j1mb0/ECE411/MotionControlledLampBOM.pdf

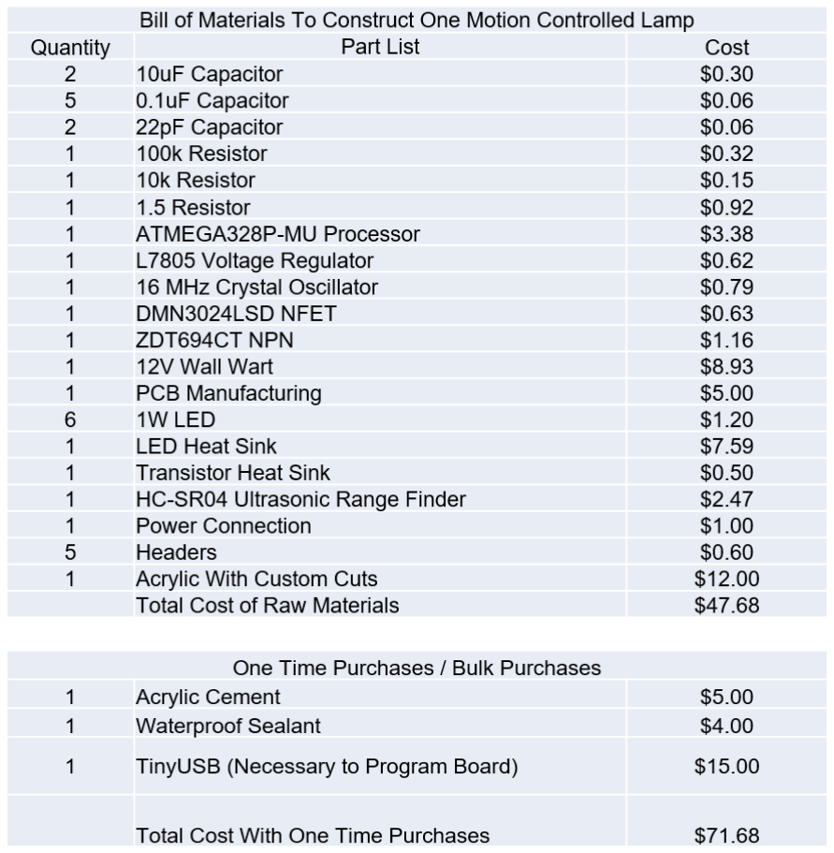
[picture p5: page 1]
