j1mb0/ECE411/T03_Eagle_Files/T03_MotionControledLampLedDriver.brd

## EAGLE design T03_Eagle_Files/T03_MotionControledLampLedDriver.brd (2015-11-16)

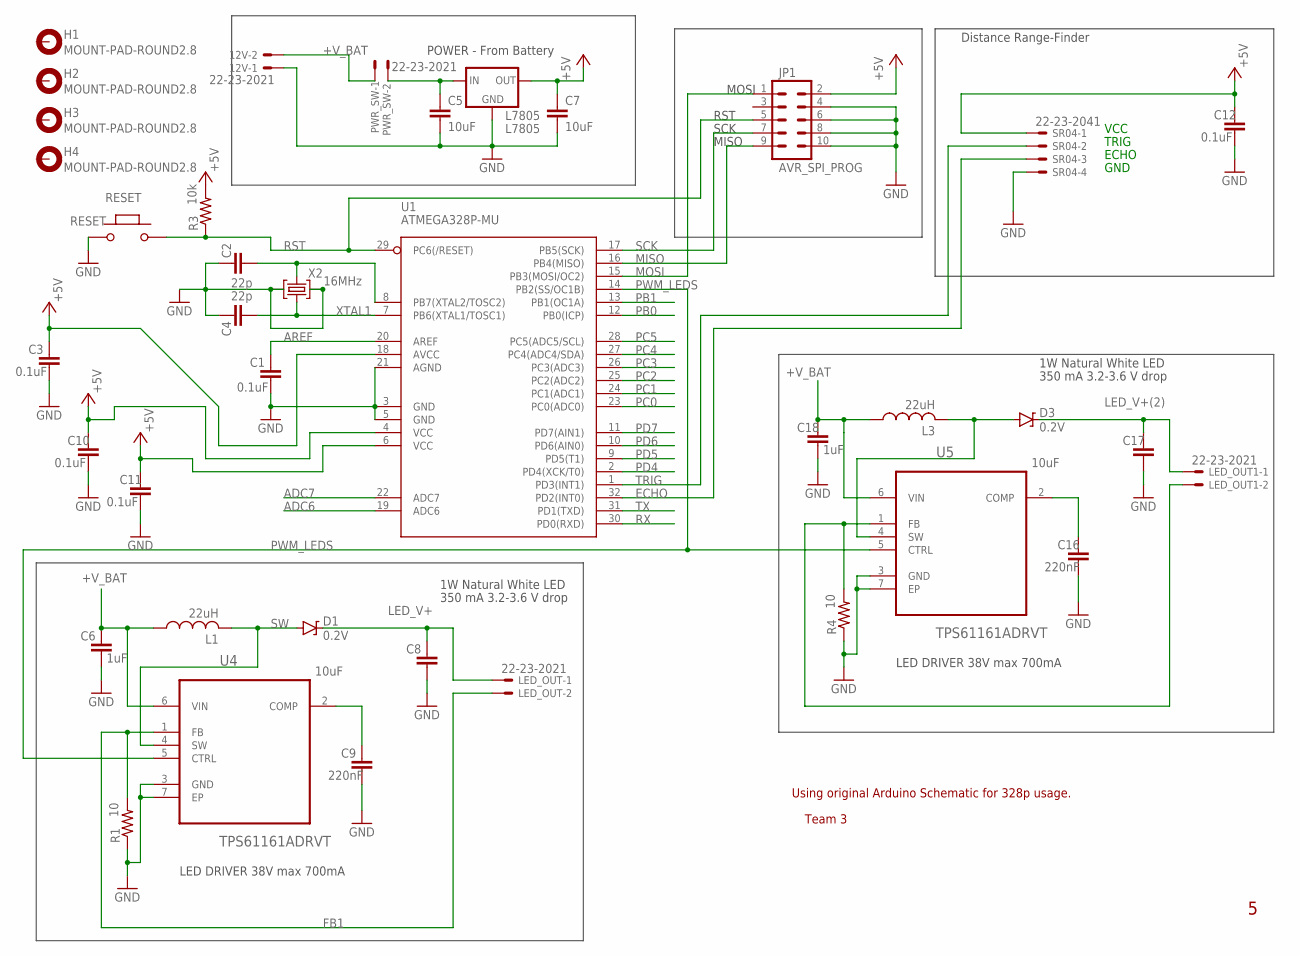
[picture p6: schematic T03_MotionControledLampLedDriver.sch]

Parts:
12V: 22-23-2021
C1, C3, C10, C11, C12: 0.1uF; C0603-ROUND
C2, C4: 22p; C0603-ROUND
C5, C7: 10uF; C1206
C6, C18: 1uF; C0603-ROUND
C8, C17: 10uF; C0603-ROUND
C9, C16: 220nF; C0603-ROUND
D1, D3: 0.2V; SOD-323
H1, H2, H3, H4: MOUNT-PAD-ROUND2.8; 2,8-PAD
JP1: AVR_SPI_PROG; 2X5-SHROUDED_LOCK
L1, L3: 22uH; L4532P
L7805: L7805; 78XXL
LED_OUT, LED_OUT1: 22-23-2021
PWR_SW: 22-23-2021
R1, R4: 10; M1206
R3: 10k; M1206
RESET: RESET; SMD_157SW
SR04: 22-23-2041
U1: ATMEGA328P-MU; TQFP32-08
U4, U5: TPS61161ADRVT; SON65P200X200X80-7N
X2: 16MHz; CRYSTAL-3.2-2.5

Connections:
+5V: C3.2, C7.1, C10.2, C11.2, C12.2, JP1.2, L7805.OUT, R3.2, SR04.1, U1.4 (VCC), U1.6 (VCC), U1.18 (AVCC)
+V_BAT: 12V.2, C6.2, C18.2, L1.1, L3.1, PWR_SW.1, U4.6 (VIN), U5.6 (VIN)
ADC6: U1.19 (ADC6)
ADC7: U1.22 (ADC7)
AREF: C1.2, U1.20 (AREF)
COMP: C9.2, U4.2 (COMP)
COMP1: C16.2, U5.2 (COMP)
ECHO: SR04.3, U1.32 (PD2(INT0))
FB1: LED_OUT.2, R1.2, U4.1 (FB)
FB2: LED_OUT1.2, R4.2, U5.1 (FB)
GND: 12V.1, C1.1, C2.2, C3.1, C4.2, C5.2, C6.1, C7.2, C8.1, C9.1, C10.1, C11.1, C12.1, C16.1, C17.1, C18.1, JP1.4, JP1.6, JP1.8, JP1.10, L7805.GND, R1.1, R4.1, RESET.1, SR04.4, U1.3 (GND), U1.5 (GND), U1.21 (AGND), U4.3 (GND), U4.7 (EP), U5.3 (GND), U5.7 (EP), X2.2 (GND), X2.4 (GND)
LED_V+: C8.2, D1.C, LED_OUT.1
LED_V+(2): C17.2, D3.C, LED_OUT1.1
MISO: JP1.9, U1.16 (PB4(MISO))
MOSI: JP1.1, U1.15 (PB3(MOSI/OC2))
unnamed: C5.1, L7805.IN, PWR_SW.2
PB0: U1.12 (PB0(ICP))
PB1: U1.13 (PB1(OC1A))
PC0: U1.23 (PC0(ADC0))
PC1: U1.24 (PC1(ADC1))
PC2: U1.25 (PC2(ADC2))
PC3: U1.26 (PC3(ADC3))
PC4: U1.27 (PC4(ADC4/SDA))
PC5: U1.28 (PC5(ADC5/SCL))
PD4: U1.2 (PD4(XCK/T0))
PD5: U1.9 (PD5(T1))
PD6: U1.10 (PD6(AIN0))
PD7: U1.11 (PD7(AIN1))
PWM_LEDS: U1.14 (PB2(SS/OC1B)), U4.5 (CTRL), U5.5 (CTRL)
RST: JP1.5, R3.1, RESET.2, U1.29 (PC6(/RESET))
RX: U1.30 (PD0(RXD))
SCK: JP1.7, U1.17 (PB5(SCK))
SW: D1.A, L1.2, U4.4 (SW)
SW1: D3.A, L3.2, U5.4 (SW)
TRIG: SR04.2, U1.1 (PD3(INT1))
TX: U1.31 (PD1(TXD))
XTAL1: C4.1, U1.7 (PB6(XTAL1/TOSC1)), X2.1 (C1)
XTAL2: C2.1, U1.8 (PB7(XTAL2/TOSC2)), X2.3 (C2)

Notes on the sheet:
POWER - From Battery
Distance Range-Finder
RST
MISO
SCK
MOSI
LED DRIVER 38V max 700mA
1W Natural White LED
350 mA 3.2-3.6 V drop
Using original Arduino Schematic for 328p usage.
Team 3
VCC
TRIG
ECHO
GND

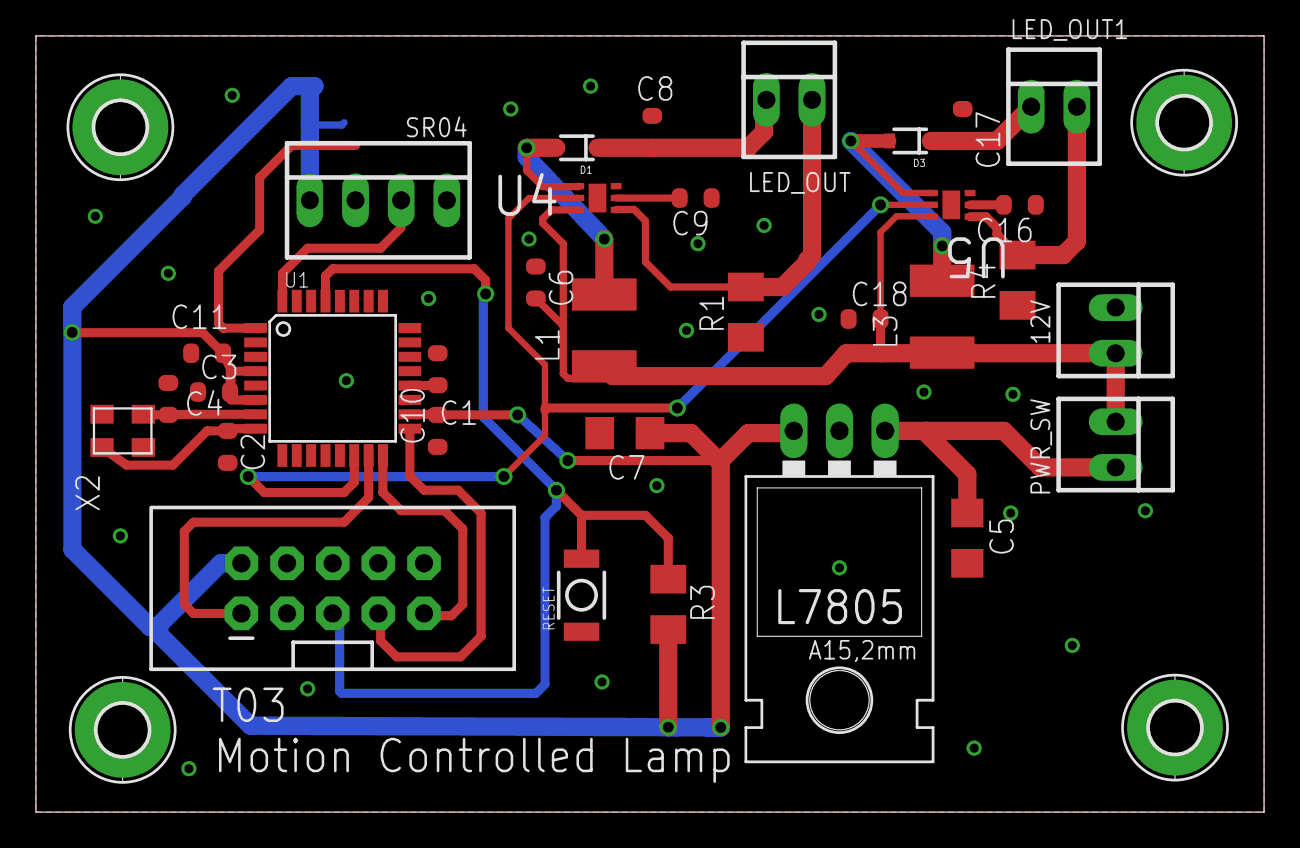
[picture p7: board T03_MotionControledLampLedDriver.brd from above]

Board: 2 copper layers, 68.3 x 43.2 mm, 38 parts (1 on the bottom side), 22 nets.
