j1mb0/ECE411/T03_Eagle_Files/LedDriverBreakout.brd

## EAGLE design T03_Eagle_Files/LedDriverBreakout.brd (2015-11-06)

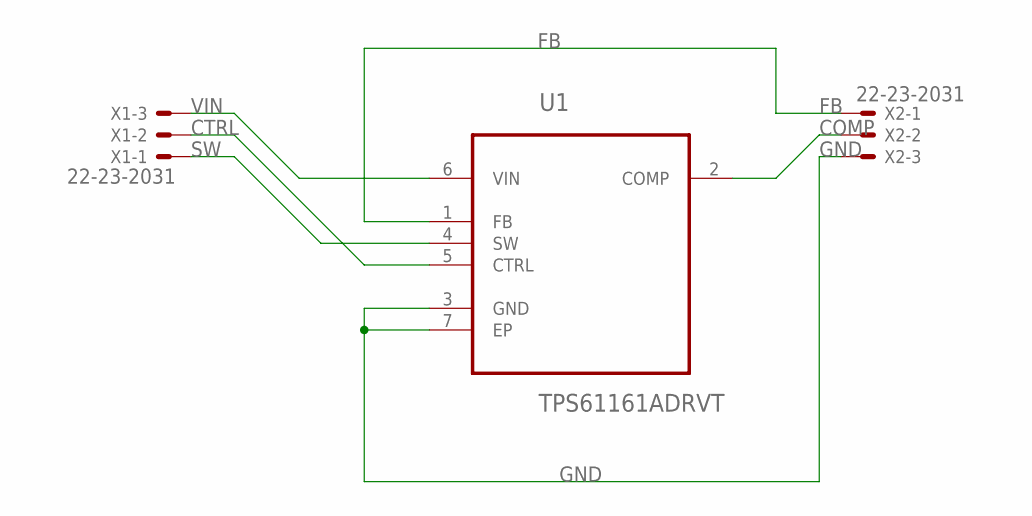
[picture p8: schematic LedDriverBreakout.sch]

Parts:
U1: TPS61161ADRVT; SON65P200X200X80-7N
X1, X2: 22-23-2031

Connections:
COMP: U1.2 (COMP), X2.2
CTRL: U1.5 (CTRL), X1.2
FB: U1.1 (FB), X2.1
GND: U1.3 (GND), U1.7 (EP), X2.3
SW: U1.4 (SW), X1.1
VIN: U1.6 (VIN), X1.3

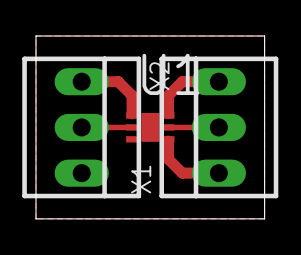
[picture p9: board LedDriverBreakout.brd from above]

Board: 2 copper layers, 12.7 x 10.2 mm, 3 parts (0 on the bottom side), 6 nets.
