j1mb0/ECE411/T03_Eagle_Files/Led_Board.brd

## EAGLE design T03_Eagle_Files/Led_Board.brd (2015-11-06)

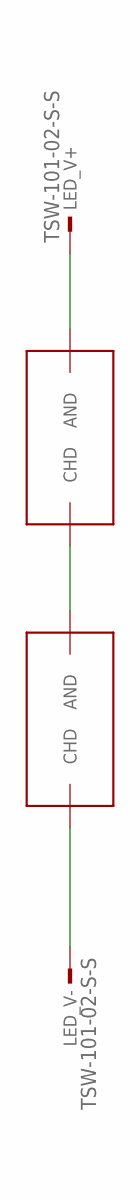
[picture p10: schematic Led_Board.sch]

Parts:
LED_V+: TSW-101-02-S-S
LED_V-: TSW-101-02-S-S
U$1, U$2: TL1F2-NW1

Connections:
unnamed: LED_V-.1, U$2.CATHODE (CHD)
unnamed: U$1.CATHODE (CHD), U$2.ANODE (AND)
unnamed: LED_V+.1, U$1.ANODE (AND)

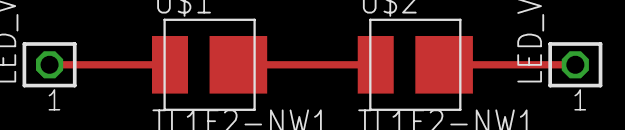
[picture p11: board Led_Board.brd from above]

Board: 2 copper layers, 4 parts (0 on the bottom side), 3 nets.
