j1mb0/ECE411/T03_DetailedTestCases.xlsx

Sheet: LED Array
Test Writer: |  | Grant Cazinha
Test Case Name: |  | LED Array Illumination Test |  |  |  | Test ID #:
Description: |  | Test Led array range of illumination using power supply. |  |  |  | Type: | White Box
Tester Information
Name of Tester: |  |  |  |  |  | Date:
Hardware Ver: |  | 1.0 |  |  |  | Time:
Setup: |  | Attach power supply leads to LED board.
Step | Action | Expected Result | Pass | Fail | N/A | Comments
1 | 0-35mA
2 | 35-70mA
3 | 70-105mA
4 | 105-140mA
5 | 140-175mA
6 | 175-210mA
7 | 210-245mA
8 | 245-270mA
9 | 270-315mA
10 | 315-350mA
Overall test result:

Sheet: Wall Wart
Test Writer: |  | Grant Cazinha
Test Case Name: |  | 12V wall wart Voltage Verification |  |  |  | Test ID #:
Description: |  | Test 12V wall wart to ensure the 12V DC is the proper output. |  |  |  | Type: | Black Box
Tester Information
Name of Tester: |  |  |  |  |  | Date:
Hardware Ver: |  | 1.0 |  |  |  | Time:
Setup: |  | Wall wart plugged into board and wall electrical socket
Step | Action | Expected Result | Pass | Fail | N/A | Comments
1 | Plug wall wart into wall electrical socket
2 | Plug wall wart into board
3 | Check voltage using oscilloscope
Overall test result:

Sheet: Voltage Regulator
Test Writer: |  | Kainoa Kekahuna
Test Case Name: |  | Voltage Regulation Verification |  |  |  | Test ID #:
Description: |  | Test voltage regulator from 12V DC to 5V DC with oscilloscope. |  |  |  | Type: | White Box
Tester Information
Name of Tester: |  |  |  |  |  | Date:
Hardware Ver: |  | 1.0 |  |  |  | Time:
Setup: |  | Plug wall wart into eletrical wall socket and plug voltage regulator into board
Step | Action | Expected Result | Pass | Fail | N/A | Comments
1 | Turn on board
2 | Test output of voltage regulator with oscilloscope
Overall test result:

Sheet: PWM Software
Test Writer: |  | Kainoa Kekahuna
Test Case Name: |  | Input Signal to Pulse Width Modulation Conversion |  |  |  | Test ID #:
Description: |  | Test sensor input data conversion. Send input test data. Allow conversion to pulse width modulation values. Compare with expected pulse width modulation values. |  |  |  | Type: | White Box
Tester Information
Name of Tester: |  |  |  |  |  | Date:
Hardware Ver: |  | 1.0 |  |  |  | Time:
Setup: |  | Input and output modules stubbed. Input file contains test data for required range of testing.
Step | Action | Expected Result | Pass | Fail | N/A | Comments
1 | Make a file with input data
2 | Stub inputs and outputs
3 | Run test
4 | Compare output data with expected
Overall test result:
