j1mb0/ECE411/(commit log)

2015-11-02 Adding schematics and board layout files
    [MotionControledLamp.brd, MotionControledLamp.sch]
2015-11-02 Updated Schematic
2015-11-02 Implementing Feedback
    [MotionControledLamp.brd, MotionControledLamp.sch, T03_MotionControledLamp.brd, T03_MotionControledLamp.sch]
2015-11-02 Removing poorly named files
    [MotionControledLamp.brd, MotionControledLamp.sch]
2015-11-06 Breakout Board Schematics + Layout
    [LedDriverBreakout.brd, LedDriverBreakout.sch, Led_Board.brd, Led_Board.sch, T03_MotionControledLamp.sch]
2015-11-06 Cleaned up LED driver breakoout for machining
    [LedDriverBreakout.brd, LedDriverBreakout.sch]
2015-11-08 Started routing. Has polygon ready. Just ratsnest and then name the polygon to GND
    [T03_MotionControledLamp.brd, T03_MotionControledLamp.sch]
2015-11-09 Completed Board Layout First Draft
    [T03_MotionControledLamp.brd, T03_MotionControledLamp.sch]
2015-11-09 Updated values of components and symbols for Board Layout
    [T03_MotionControledLamp.brd, T03_MotionControledLamp.csv, T03_MotionControledLamp.sch]
2015-11-09 Added molex headers to schematic
    [T03_MotionControledLamp.brd, T03_MotionControledLamp.csv, T03_MotionControledLamp.sch]
2015-11-09 Updated board layout for molex connects
    [T03_MotionControledLamp.brd, T03_MotionControledLamp.sch]
2015-11-16 Board Layouts finished, ready for OSH
    [DigiKeyBom.csv, DigiKeyBom.xlsx, T03_MotionControledLampLedDriver.brd, T03_MotionControledLampLedDriver.sch, T03_MotionControledLampNFET.brd, T03_MotionControledLampNFET.sch]
2015-11-23 The detailed test cases for the project
    [T03_DetailedTestCases.xlsx]
2015-12-06 Test Results
    [T03_DetailedTestCases_Complete.xlsx]
2015-12-11 Adding Final Files
    Adding BOM and Final Iterations of the Presentation and Test Plan.
